DianaCortesX/SpinIt3D/Electrical_Connection_Guide.pdf

# Spin It 3D

# Electrical Subsystem Connection Guide

## Clear wiring plan for the MCU, display, sensors, solenoid lock, and motor-

speed control.

## Polytechnic University of Puerto Rico Biomedical Engineering Department

Students:
Paola Colon
Diana Cortes
Bethzaely Sierra
Jahdiel Perez

Mentors:
Prof. Ricardo Bravo & Dr. Jairo Rondon

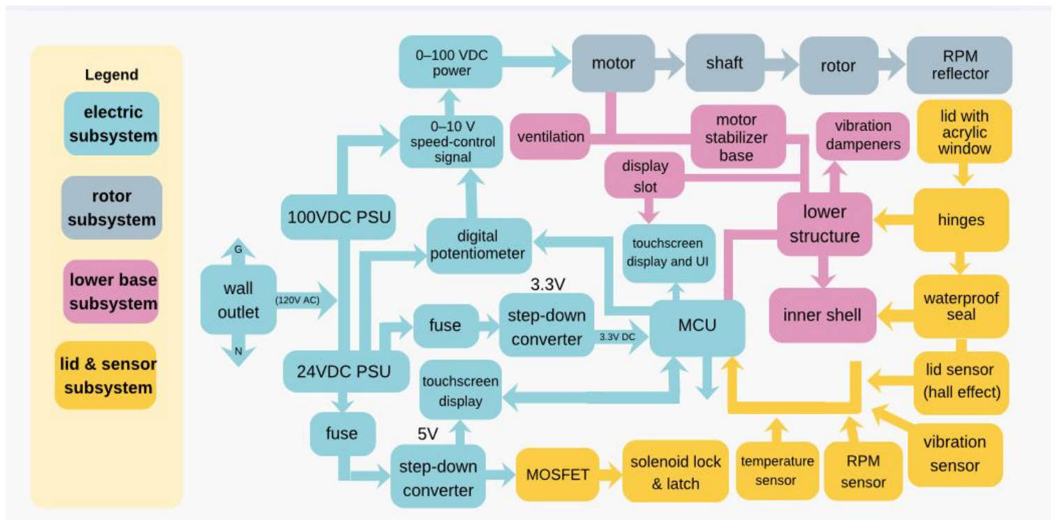
[picture p16: page 2]

Electrical subsystem overview | What connects to what

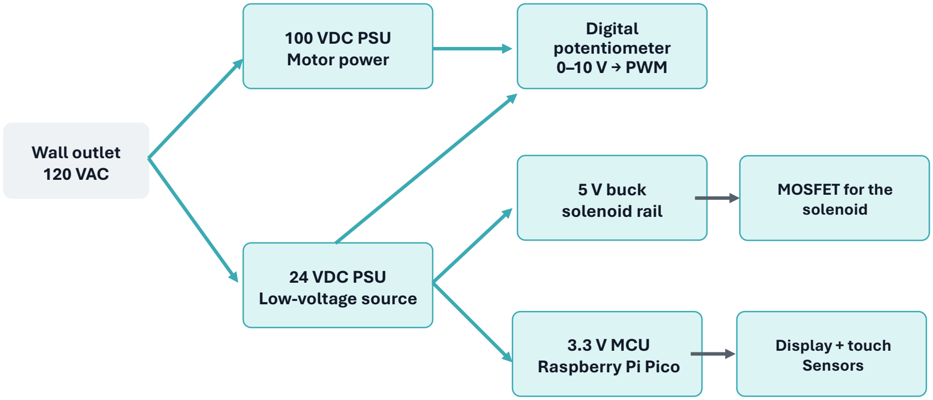
[picture p17: figure]
Wall outlet 120 VAC; 100 VDC PSU Motor power; 24 VDC PSU Low-voltage source; Digital potentiometer 0–10 V → PWM; 5 V buck solenoid rail; 3.3 V MCU Raspberry Pi Pico; Display + touch Sensors; MOSFET for the solenoid

Spin It 3D | Electrical Subsystem

Use two power paths: high power for the motor and low power for control electronics. The MCU commands speed; it should never carry motor current.
All low-voltage modules need a shared ground reference where signals are exchanged.

Power distribution and grounding | First connection rule

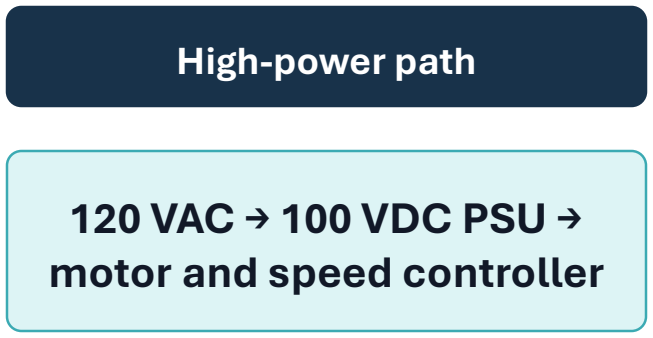
[picture p18: figure]
High-power path; 120 VAC → 100 VDC PSU → motor and speed controller
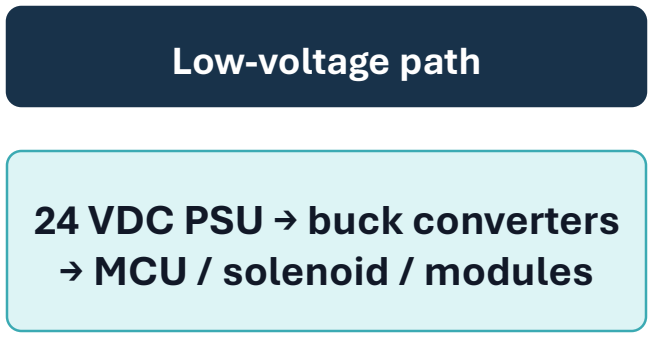
[picture p19: figure]
Low-voltage path; 24 VDC PSU → buck converters → MCU / solenoid / modules

Put a fuse on each supply branch before it feeds the load.

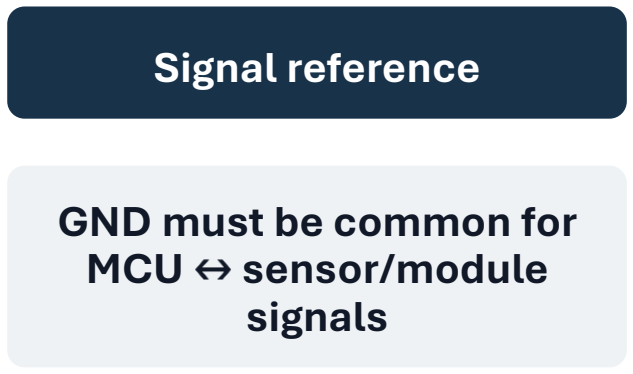
[picture p20: figure]
Signal reference; GND must be common for MCU sensor/module signals

Do not connect the 100 V motor output to the MCU, sensors, display, or breadboard. Route motor wires away from sensor and touchscreen signal wires to reduce noise. Use thicker wire for motor and solenoid current; use signal wire only for GPIO lines.

Key idea: power lines deliver current; GPIO lines only send commands.

Touchscreen display connection | MCU TFT + XPT2046 touch

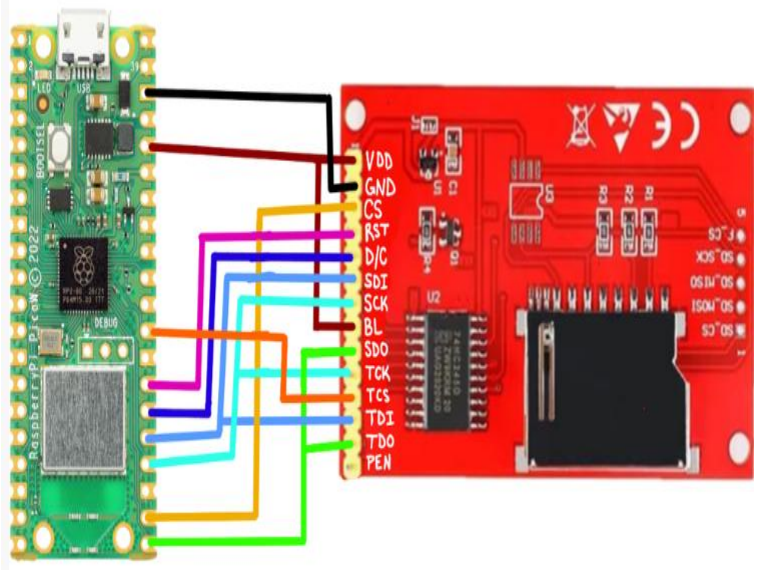
[picture p21: figure]

### Use 3.3 V logic

VDD → 3V3, GND → common GND, BL → 3V3 or display backlight control.
SPI bus: SCK → GP18, SDI/MOSI → GP19, SDO/MISO → GP16.
TFT control: CS → GP17, D/C → GP21, RST → GP20. Touch control: TCS → GP22; TDI and TDO share the SPI lines; PEN can stay unused.

In code, keep the display pins grouped in one “pin_config.h” file so changes are easy.

Sensors connection pattern | Same idea for lid, RPM, temperature, and vibration

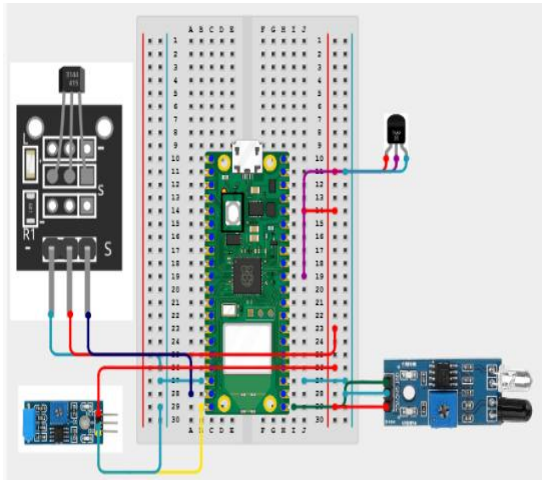
[picture p22: figure]

### Each sensor needs 3 lines

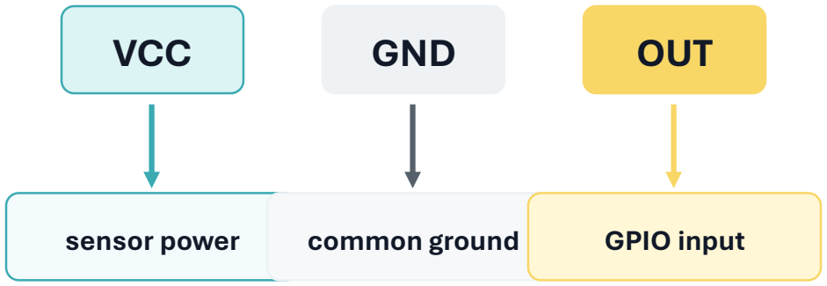
[picture p23: figure]
VCC; GND; OUT; sensor power; common ground; GPIO input

Hall lid sensor: OUT changes when the lid magnet is near the sensor.
IR RPM sensor: OUT pulses each time the rotor reflector passes.
Temperature and vibration sensors: OUT goes to analog or digital GPIO depending on the module.

Solenoid lock connection | GPIO controls current through a MOSFET

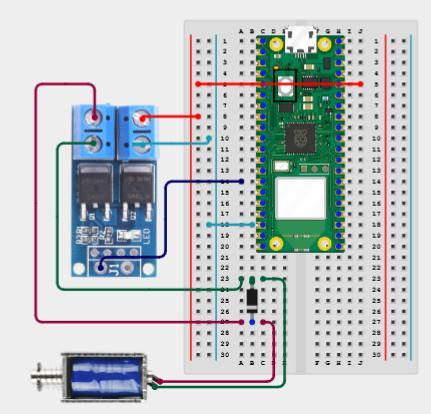
[picture p24: figure]

### Solenoid wiring

+5 V buck output → solenoid positive lead. Solenoid negative lead → MOSFET drain.
MOSFET source → 5 V supply and ground. Flyback diode across solenoid: stripe side to +5 V.

The Pico pin only switches the MOSFET gate. The solenoid current comes from the 5 V buck supply, not from the Pico.

Motor speed-control connection | MCU command → 0–10 V signal → motor PSU

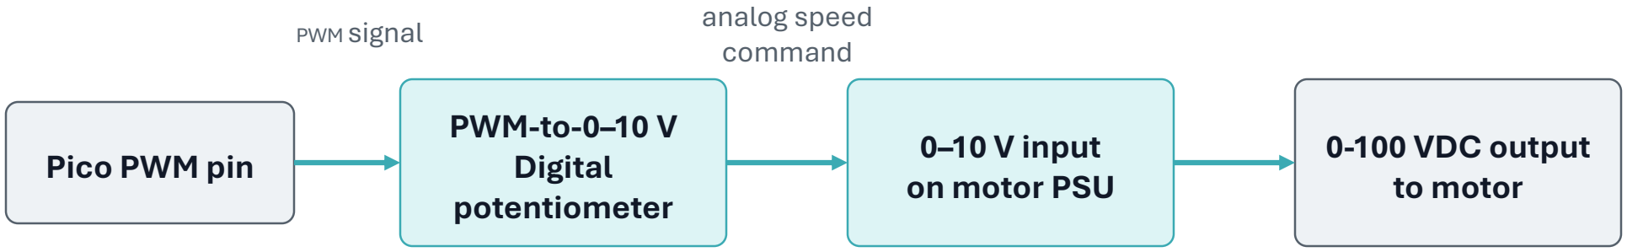
[picture p25: figure]
Pico PWM pin; PWM-to-0–10 V Digital potentiometer; 0–10 V input on motor PSU; 0-100 VDC output to motor; PWM signal; analog speed; command

Power the converter from the 24 V rail if the module accepts 12–30 V.
Connect converter OUT+ and GND/OUT− to the PSU’s 0–10 V speed input terminals. Calibrate the module so 0% PWM ≈ 0 V and 100% PWM ≈ 10 V.
Keep the 100 V motor output isolated from the MCU and breadboard.

Bring-up checklist | Test one block at a time

1

Verify each power rail with a multimeter before connecting loads and ensure GND continuity.

2 Power the Pico + display only; confirm the UI loads correctly.

3 Add sensors and check that each GPIO changes state in serial monitor.

4

Test the solenoid with a short timed pulse and align it with the latch before installing it on the lid.

5 Test motor speed control with no rotor first, then with a balanced rotor and enclosure.

Never test a high-speed rotor without containment, lid interlock, and emergency stop available.
